evannroche/ESP32-Walkie-Talkie/(commit log)

2026-01-22 Remove battery life detail from README
    Removed battery life specification from performance characteristics.
2026-08-07 Improve ADC sampling
